uhi22/ccs32dave/readme.md

# ccs32dave - The CCS Sniffer with ESP32-S3, QCA7005 modem and TFT display

ccs32dave live during a charging session: the log shows CurrentDemandReq/Res in both directions, and the right-hand panel shows TARGET 230.0V/10.0A, PRESENT 231.0V/10.0A, SoC 0%, and the last message CurrentDemandReq OK.

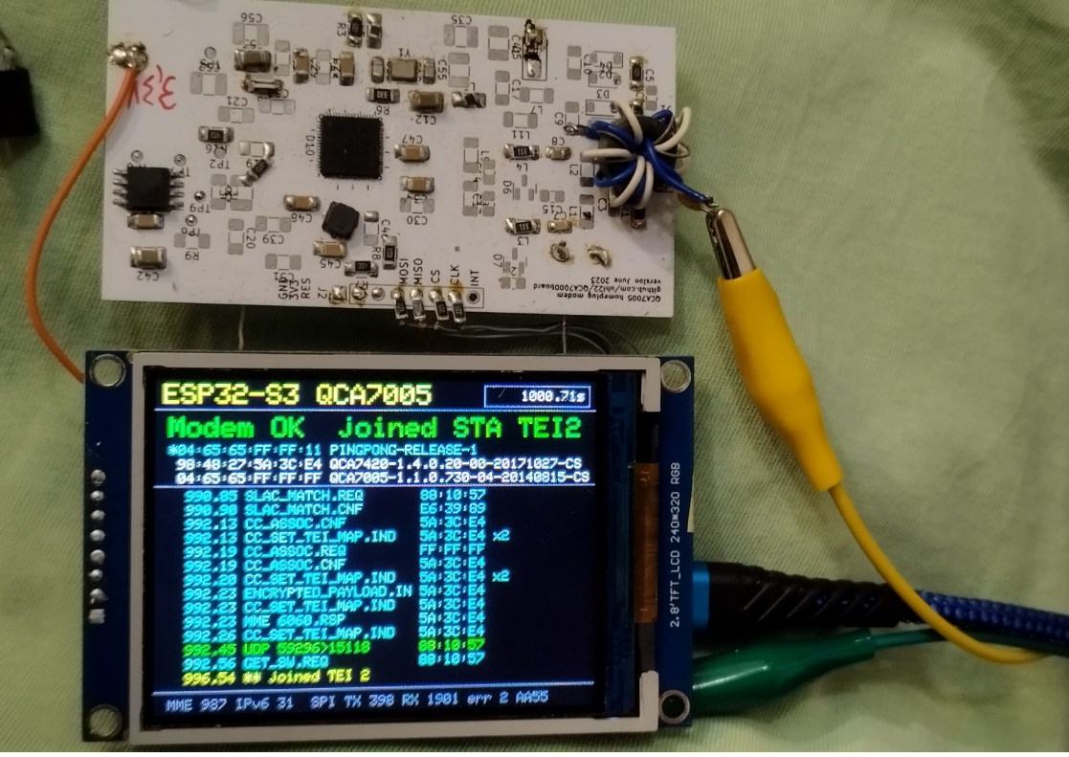
[picture p1: doc/2026-09-14_TFT_and_QCA_showing_SLAC_and_UDP.jpg]
QCA7005 modem board wired to the ILI9341 TFT (earlier state - see "News" below for what changed since).


## News

- **Unjoined in-modem decrypt (V7014):** the local modem no longer joins the powerline network to
  make the traffic visible. It stays a passive, non-member listener, recovers the session key and
  decrypts the charging traffic inside the modem, and delivers the plaintext to the host - a less
  intrusive sniffer than the earlier join-and-forward firmware. This ESP32 firmware now pairs with
  the V7014 modem image (`qca-modem-firmware/make_v7014_release.py`); the older `PINGPONG-RELEASE-5`
  pair is in the git history. Flash the ESP32 and the modem from the same commit.
- Milestone reached: also for the AR7420 we have now a transparent sniffer software, see [pyPLC](https://github.com/uhi22/pyPLC#2026-10-09-ar7420-full-transparency-sniffer)
- **ccs32dave works in a real-world charging session:** sniffing tested successfully on a Hyundai Ioniq
  charging at an Alpitronic HYC300. See the [video on YouTube](https://www.youtube.com/watch?v=CvkjcjtfIfo).
- **Live DIN 70121 decode**, both directions: target/present voltage and
  current, SoC and the last message name and response code, updating in real time on the TFT.
- **New two-column screen:** a prominent V2G value panel next to the frame log, plus a splash screen at boot (project name, GitHub link, build date, local modem version).
- **Beacon meter:** shows whether a charger's modem (CCo) is in sight and how well its beacons are received, from the modem's 250 ms status frame.
- **Stale values fade out:** V2G values that are no longer updated turn gray.
- **Page 2 (push button):** SDP transport security (TLS or not) and the XML schemas offered by the car and selected by the charger. A red `TLS` in the header warns that the session is encrypted.
- **Page 3 (push button):** the charge parameter discovery - the car's limits next to the charger's, so it is visible which side caps the session.
- **Pages 4-9:** session timeline, SLAC attenuation profile, a live voltage/current chart, identity and keys (including the session's NID and NMK), the energy delivered, and a message ladder diagram.

## Description

Arduino project that drives an **ILI9341 SPI TFT** (240×320) and a **QCA7005 HomePlug Green PHY modem** (compatible with QCA7000) from an **ESP32-S3**. Passively decodes the ISO 15118 / DIN 70121 charging session between a car and a charger and shows the live values on the TFT.

At boot, a **splash screen** shows for ~5 s: project name, GitHub link, build date/time, and (if it answers in time) the local modem's own software version - then switches to the main screen below.

The main screen shows:

- The local modem's status (SPI signature)
- A **beacon meter** (`beacons` + 5 segments): how well a charger's modem (CCo) is being received, from the delimiter counts in the modem's 250 ms status frame. Grey and empty when no status frame or no beacons arrive. The V7014 modem never joins a network, so there is no join/role/TEI to show.
- Up to 3 modems in the network with MAC and software version (HomePlug `GET_SW`). The local modem, whose MAC ends in `FF:FF:11`, is marked with `*`.
- Below the modem panel, two columns: a **frame log** on the left (events, MME/message names, UDP) and a prominent **V2G value panel** on the right - big stacked numbers for target/present voltage and current, SoC, the last decoded message name and its response code
- Traffic, delimiter (SOF/SACK, from the status frame) and SPI counters
- In the header: the uptime in seconds with **10 ms resolution**, refreshed every **50 ms** (20 Hz), and a red `TLS` once the charger's SDP response selected TLS (orange `TLS?` if only the car's request asked for it)

A push button (see "Page button" below) cycles through the nine pages and back to the main page. Over the serial line, `page <n>` jumps straight to one.

Page 2 is one page in two stacked parts, each with its own heading in the same format (yellow, size 2, same left edge) and a single separator line between them - no line under the top heading:

- **SDP:** what the car requests (TLS / no TLS, TCP / UDP), what the charger answers (the same, plus its IPv6 address and TCP port). Green = no TLS, red = TLS.
- **schema** (the lower section's heading): up to 5 schemas offered by the car (SchemaID, priority, version, namespace such as `urn:din:70121:2012:MsgDef`), the charger's response code, and the selected one marked with `>` - the negotiated protocol is repeated at the bottom in size-3 digits (e.g. `-> DIN 70121`), since that is the page's conclusion.
- The page stays coloured while the session is alive (any SDP or V2G message) and grays as a whole after 3 s without traffic. A SLAC match clears it, so values of the previous session can't reappear as current.
- Page 2 has no `ccs32dave` and no uptime either. **Only the main page has the uptime box**; every other page uses the header band for a heading, and the `TLS` warning moves to the right edge in small text.

Page 3 shows the **charge parameter discovery** in two columns - the car's request on the left (yellow, like the main page's TARGET block), the charger's response on the right (green, like PRESENT):

- **Car** (`ChargeParameterDiscoveryReq`): requested energy transfer mode (e.g. `DC extended`), maximum voltage and current in size-3 digits, the SoC sent with the request, the `EVReady` flag, the optional `full` / `bulk` SoC targets and the DC error code (green `NO_ERROR`, otherwise red; the names are shortened to fit, the full DIN names are in the comment above `evErrorName()`).
- **Charger** (`ChargeParameterDiscoveryRes`): `Ongoing` (orange) or `Finished` (green), maximum voltage, current and power in size-3 digits, the minimum voltage and current, and the response code.
- Fields the message doesn't carry show `-`: the SoC targets and the maximum power are optional in DIN, and while the charger answers `Ongoing` it may leave out its whole parameter block.
- Same session colouring as page 2 (gray after 3 s of quiet, cleared on a SLAC match).
- The header belongs to the page: `ccs32dave` and the uptime box are replaced by the page name, and the `TLS` warning moves to the right edge in small text (with TLS there is no discovery data to show at all). Both come back on pages 1 and 2.

Pages 4 to 9 each take one topic. Like page 3, they put their own name in the header in place of
`ccs32dave` and the uptime, and they gray out together with pages 2 and 3 once the session has
been quiet for 3 s:

- **Page 4 - session timeline** (backlog_0014): one bar per phase (SLAC, join, SDP, handshake,
  setup..CPD, CableCheck, PreCharge, CurrentDemand, stop) with its duration. Green = finished,
  yellow = running, red = this is where the session stopped, grey = never reached. Bar length is
  the phase's share of the longest one.
- **Page 5 - SLAC quality** (backlog_0015): the attenuation profile from `CM_ATTEN_CHAR.IND`, one
  bar per carrier group in dB (green below 30, yellow below 45, red above), plus the number of
  sounds received, the SLAC duration and the average and worst attenuation. **On this bench the
  profile is synthetic**: pyPLC has no measurements from the AR7420 and sends a constant 9 dB with
  three rising values at the top end, so the curve does not move. Against a real charger it is a
  fingerprint of the coupling.
- **Page 6 - voltage and current** (backlog_0016): a sweeping plot of the present voltage (green,
  left scale) and current (yellow, right scale) over the last 120 s, one sample per 400 ms. The
  newest sample overwrites the oldest column, so the two-pixel gap shows where "now" is. Both
  scales round up to a readable step on their own, and the current values stand above the plot.
- **Page 7 - identity and keys** (backlog_0017): the car (EVCCID, or the PEV MAC from the SLAC
  match), the charger's MAC, the V2G SessionID, and the NID and NMK the session runs on. The
  payment option was dropped as uninteresting (owner decision 2026-09-22).
- **Page 8 - energy** (backlog_0020): energy in kWh and charge in Ah integrated over the present
  values, average and peak power, how long current actually flowed, and the phase reached.
- **Page 9 - message ladder** (backlog_0021): car on the left rail, charger on the right, one
  arrow per exchange with an arrowhead per direction. Repeats of the same exchange collapse into
  one row with a count (`CurrentDemand x176` with a two-way arrow), so a charge loop doesn't push
  the session start off the page.

```
+-------------------------------------------------------+
| ccs32dave       (yellow, size 2)       [    1234.56s] |
|---------------------------------------------------------
| Modem OK (green/red)     beacons [#####]  (size 2)     |
| *04:65:65:FF:FF:11 <local version>            (cyan)   |
|  98:48:27:5A:3C:E4 QCA7420-1.4.0.20-00-20171027-CS     |
|  04:65:65:FF:FF:FF QCA7005-1.1.0.730-04-20140815-CS    |
|------------------------------------|------------------|
| 12.3 ** modem OK             (yel) | TARGET     (grey)|
| 13.1 SLAC_PARAM.REQ    10:57 (cy)  | 230.0V   (yellow)|
| ...                                 | 10.0A    (yellow)|
| 16.0 SessionSetupReq   10:57 (grn) | PRESENT    (grey)|
| 16.1 CurrentDemandReq  10:57 (grn) | 230.0V    (green)|
| 16.1 CurrentDemandRes  39:89 (grn) | 10.0A     (green)|
|  ... (14 lines, newest at bottom)  | SoC        (grey)|
|                                     | 0%          (cy)|
|                                     | CurrentDemandRes |
|                                     | OK         (grn) |
|---------------------------------------------------------
| MME 42 IPv6 800  SPI TX 24 RX 1900 err 0 AA55  (grey)  |
+-------------------------------------------------------+
```

Page 3 (charge parameter discovery) - the page name replaces `ccs32dave` and the uptime box in
the header here, so the values can use the whole screen:

```
+-------------------------------------------------------+
| ChargeParameterDiscovery       (yellow, size 2)  [TLS] |
|---------------------------------------------------------
| CAR wants          (grey) | CHARGER          (grey)    |
| DC extended      (size 2) | Finished     (size 2, grn) |
| maximum             (grey)| maximum             (grey) |
| 410.0V   (yellow, size 3) | 450.0V     (green, size 3) |
| 125.0A   (yellow, size 3) | 200.0A     (green, size 3) |
| SoC 0%     (cyan, size 2) | 10.0kW     (green, size 3) |
| ready no (orange, size 2) | minimum             (grey) |
| full 100%  bulk 80%       | 200V 1A          (size 2)  |
| EV error code       (grey)| response            (grey) |
| NO_ERROR  (green, size 2) | OK         (green, size 2) |
|---------------------------------------------------------
| button: main page                               (grey) |
+-------------------------------------------------------+
```

Planned next steps are in [backlog.md](backlog.md).

## Project layout

```
readme.md                                    this file
backlog.md                                   planned work
doc/                                         photos
ccs32dave-arduino-esp32-s3-tft-ili9341.ino   Arduino sketch: display, splash screen, scheduling
qca7000.h/.cpp                               QCA7000/QCA7005 SPI driver
homeplug.h/.cpp                              HomePlug messages (GET_SW, NW_INFO, MME names,
                                              vendor MMEs VS_RD_MEM/VS_WR_MEM/VS_NW_INFO)
modem_list.h/.cpp                            table of the modems in the network
diag.h/.cpp                                  serial diagnosis interface (rd/wr/nwi/pp/stat/...)
v2gtp.h/.cpp                                 TCP reassembly + V2GTP framing (no TCP stack)
v2g_exi.h/.cpp                               DIN 70121 / app-handshake EXI decode glue
src/exi/                                     OpenV2G EXI codec (decoder-only), ported from
                                              ccs32berta - see backlog.md backlog_0001 step 2
qca-modem-firmware/                          script that builds the modem's sniffer firmware
                                              (see "QCA7005 sniffer firmware")
```

The sketch folder is the repository root. Arduino requires the `.ino` file to have the same name as its folder.

The modem code is ported from [ccs32berta](https://github.com/uhi22/ccs32berta) and cleaned up into small C++ modules; so is the EXI codec in `src/exi/` (decoder-only - only the DIN and app-handshake decoders are used, not the encoders).

## Hardware

- ESP32-S3 board with an ESP32-S3-WROOM-1 module and two USB-C ports labeled "USB" and "COM" (DevKitC-1 style). Tested with this board.
- ILI9341 SPI TFT module **without CS and MISO**, with the 7 pins `GND VCC CLK MOSI RES DC BLK`. This is the same module as in the STM32 project `TFT-with-CAN`.
- QCA7005 (or QCA7000) HomePlug modem with SPI access (3.3 V logic)
- Jumper wires

## Wiring

The TFT and the modem use **two separate SPI buses**. The TFT has no CS, so it would react to the modem's SPI traffic.

### TFT display (FSPI bus)

| TFT pin | ESP32-S3 pin | Sketch define | Notes |
|---|---|---|---|
| GND | GND | | |
| VCC | 3V3 | | Supply for the display controller |
| CLK | GPIO 12 | `TFT_SCLK` | FSPI SCK |
| MOSI | GPIO 11 | `TFT_MOSI` | FSPI MOSI |
| RES | GPIO 8 | `TFT_RST` | Hardware reset |
| DC | GPIO 9 | `TFT_DC` | Data/command select |
| BLK | 5V | `TFT_BL = -1` | Backlight, always on. Or use a GPIO (see notes) |
| *(CS)*  | – | `TFT_CS = -1` | Not on the module |
| *(MISO)*| – | `TFT_MISO = -1` | Not on the module |

The chosen GPIOs are free on every ESP32-S3 module variant. The wiring avoids GPIO 26–32 (SPI flash), GPIO 33–37 (octal PSRAM on N8R8 / N16R8 modules), GPIO 19/20 (USB D-/D+), GPIO 0/3/45/46 (strapping pins) and GPIO 43/44 (UART0, used by the "COM" port).

#### TFT notes

- **No CS:** the controller's chip select is tied active on the module, so the display must be the **only device on this SPI bus**. In the sketch, `TFT_CS` and `TFT_MISO` are set to `-1`, and the Adafruit driver then skips CS handling. The display is write-only, so MISO isn't needed.
- **SPI mode:** mode 0 (clock idle low, sample on the first edge), the same as in the STM32 project. The Adafruit driver uses mode 0 by default.
- **Backlight:** to switch the backlight from software, connect `BLK` to a free GPIO (e.g. GPIO 7) and set `#define TFT_BL 7` in the sketch. The backlight draws several tens of mA. If the module has no backlight transistor, use a small NPN/MOSFET switch instead of driving it directly from the GPIO.
- Keep the wires short (< 15 cm). The SPI clock runs at 40 MHz; the STM32 project used 18 MHz. If the picture shows glitches, lower `SPI_FREQUENCY` to `20000000`.
- To use different pins, change the `#define TFT_*` lines at the top of the sketch. The ESP32-S3 can route SPI to any free GPIO.

### QCA7005 modem (HSPI bus)

| QCA7005 pin | ESP32-S3 pin | Sketch define | Notes |
|---|---|---|---|
| GND | GND | | |
| SPI_CLK | GPIO 4 | `QCA_SCLK` | |
| SPI_SI | GPIO 5 | `QCA_MOSI` | ESP32 → modem |
| SPI_SO | GPIO 6 | `QCA_MISO` | Modem → ESP32 |
| SPI_CS | GPIO 15 | `QCA_CS` | Active low |
| INT | – | | Not connected; the sketch polls |

#### QCA7005 notes

- **SPI settings:** mode 3 (clock idle high) at 4 MHz. ccs32berta used 2 MHz; 4 MHz gives headroom for the sniffer stream and measured no SPI errors, while 8 MHz did (`QCA_SPI_FREQUENCY`).
- **Supply:** check the modem board's supply voltage before connecting. The SPI lines must be 3.3 V logic.
- **No interrupt:** the sketch polls the modem's receive buffer every 10 ms instead of using INT.
- **Diagnosis:** if the display shows `Modem: missing`, the signature read didn't return `AA55`. `FFFF` or `0000` usually means a wiring problem (MISO, CS, CLK) or no supply. While the signature is wrong, the serial port prints all internal registers every second (`QCA regs: ...`). If they all have the same value, the modem isn't decoding the commands.
- **Tested with:** local QCA7005 running the V7014 sniffer firmware (MAC `04:65:65:FF:FF:11`, unjoined in-modem decrypt - it never joins the network, decrypts the overheard traffic in the modem and delivers the plaintext to the host in both directions, on its own), on a testbench with a PEV modem (QCA7005, `MAC-QCA7005-1.1.0.730-04-20140815-CS`) and an EVSE modem (QCA7420, `MAC-QCA7420-1.4.0.20-00-20171027-CS`). Serial output after a reset:
  ```
  QCA7005 signature: AA55 (OK)
  ccs32dave started
  Modems: 1
    * 04:65:65:FF:FF:11 <local version>
  ```
  The local modem never joins, so it stays the only station it reports. Other modems answer
  `GET_SW` on the powerline, so the modem table may still list the PEV and EVSE modems while a
  session runs.

#### QCA7005 sniffer firmware

This ESP32 firmware pairs with the QCA7005 sniffer firmware **V7014**, built by
`qca-modem-firmware/make_v7014_release.py`. (The earlier join-and-forward `PINGPONG-RELEASE-5`
firmware and its builder are in the git history; flash the matching pair from one commit.)

V7014 is an **unjoined in-modem decrypt** sniffer: the modem never joins the powerline network. It
passively overhears the charging traffic, recovers the session key and decrypts the payload inside
the modem, and delivers the plaintext to the host as native IPv6 frames plus a 250 ms status frame
(which drives the beacon meter and the SOF/SACK counters). This repository doesn't contain the
firmware, because it is based on the modem vendor's firmware; the script builds the image from an
original flash image that you obtain yourself:

1. The input is an original 2 MB SPI flash image with the QCA7005 firmware
   `MAC-QCA7005-1.1.0.730-04-20140815-CS`. Apart from the per-device parameter blocks (PIB:
   MAC address, keys), it must be identical to the image this release was tested with. The
   script checks this and refuses anything else. Your image's own keys are kept. The file name
   doesn't matter; the default is `original_1.1.0.730-04-CS-20140815.bin`. (The same original
   image also works with the older `make_pingpong_release_5.py` in the git history.)
2. Build the image (only Python 3 is needed):
   ```
   python qca-modem-firmware/make_v7014_release.py original_1.1.0.730-04-CS-20140815.bin
   ```
   This writes `qca_flash_V7014.bin` with the MAC `04:65:65:FF:FF:11`. Use
   `--mac` for a different one. The MAC must differ from every other modem on the line. The input
   dump uses `04:65:65:FF:FF:FF`, like many other boards (e.g. Foccci).
3. Write the image to the QCA7005's SPI flash with any SPI flash programmer. One way is a
   Raspberry Pi with `flashrom`, with the QCA7005 held in reset while flashing. **Read a backup
   of the original flash first.**

The modem only boots a compressed firmware of exactly the right size, so the script checks that
its result is bit-identical to the build tested on hardware. If it isn't, the script stops and
writes nothing. It was tested on Windows 10 x64 with Python 3.11.7.

**Disclaimer, use at your own risk, no warranty:** flashing can leave the modem unusable until it
is flashed again with a working image. This firmware passively decrypts the charging traffic it
overhears, in the modem. Use it only on your own equipment or where you are allowed to, and be
aware that even a passive, non-joining station in range can in principle affect a charging session.

### Page button

| Button | ESP32-S3 pin | Sketch define | Notes |
|---|---|---|---|
| one side | GPIO 16 | `PAGE_BUTTON_PIN` | Internal pull-up; a press steps to the next of the nine pages and wraps to the main page (30 ms debounce). `page <n>` on the serial line jumps directly |
| other side | GND | | |

GPIO 16 is free on every ESP32-S3 module variant (it is only a 32 kHz crystal pin if such a crystal is fitted, which the DevKitC-1 doesn't have). The BOOT button isn't used because it's hard to reach.

## Software

### Requirements

- Arduino IDE 2.x **or** just `arduino-cli`. The IDE isn't needed; see [Command line only](#command-line-only-no-arduino-ide)
- **esp32** board package by Espressif, version 3.x (tested with 3.0.2)
- Libraries, from the Library Manager:
  - **Adafruit ILI9341** (tested with 1.6.3)
  - **Adafruit GFX Library** (tested with 1.12.6)
  - **Adafruit BusIO**, which is installed automatically as a dependency

The sketch uses the Adafruit libraries rather than TFT_eSPI. TFT_eSPI has known compatibility problems with esp32 core 3.x on the ESP32-S3.

### Board settings (Arduino IDE)

- Board: **ESP32S3 Dev Module**
- Everything else can stay at the defaults

### USB port

Connect the board's **"COM"** USB-C port. It has a USB-to-serial chip on UART0, which:

- puts the ESP32 into download mode automatically, so you don't need to press BOOT/RESET
- shows `Serial` output without the "USB CDC On Boot" setting
- stays available when the sketch crashes

The "USB" port is the ESP32-S3's native USB and isn't needed here. If Windows shows no COM port, install the driver for the USB-to-serial chip (CH343 or CP210x).

### Command line only (no Arduino IDE)

Everything (setup, build, upload, serial monitor) works with `arduino-cli` alone.

**1. Install arduino-cli**

```sh
winget install ArduinoSA.CLI
```

Or download it from <https://arduino.github.io/arduino-cli/latest/installation/>. If the Arduino IDE 2.x is already installed, it contains a copy of the CLI:
`%LOCALAPPDATA%\Programs\Arduino IDE\resources\app\lib\backend\resources\arduino-cli.exe`

**2. Install the ESP32 board package and the libraries** (one time)

```sh
arduino-cli config init
arduino-cli config add board_manager.additional_urls https://espressif.github.io/arduino-esp32/package_esp32_index.json
arduino-cli core update-index
arduino-cli core install esp32:esp32
arduino-cli lib install "Adafruit ILI9341" "Adafruit GFX Library"
```

`arduino-cli config init` fails if a config file already exists, e.g. because the Arduino IDE created one. That's fine: continue with the next command. To get the tested version, use `esp32:esp32@3.0.2`.

#### Already set up on the dev/bench PC (2026-09-15)

Everything above is already installed on the Windows machine this project is normally worked on
from (`C:\UwesTechnik\...`) - no need to (re-)install, just use these paths directly:

- `arduino-cli.exe`: `C:\Users\uwemi\AppData\Local\Programs\Arduino IDE\resources\app\lib\backend\resources\arduino-cli.exe`
  (bundled with Arduino IDE 2.x, no separate `arduino-cli` install)
- Board package: `esp32:esp32` 3.0.2, in the default `Arduino15` data dir (`arduino-cli core list` to confirm)
- Libraries: **not** in the default `Documents\Arduino\libraries` - this account's Documents is
  OneDrive-redirected, so they're under
  `C:\Users\uwemi\OneDrive\Dokumente\Arduino\libraries\` (`Adafruit_GFX_Library` 1.12.6,
  `Adafruit_BusIO` 1.17.4, `Adafruit_ILI9341` 1.6.3 - `arduino-cli lib list` to confirm/update)
- Compile-check (no upload, no board needed - use this to verify a change before touching hardware):
  ```sh
  "C:\Users\uwemi\AppData\Local\Programs\Arduino IDE\resources\app\lib\backend\resources\arduino-cli.exe" compile --fqbn esp32:esp32:esp32s3 "C:\UwesTechnik\ccs32dave-arduino-esp32-s3-tft-ili9341"
  ```
- The ESP32 is on **COM11** on this bench (fixed, not just the doc's placeholder value) - confirm with `arduino-cli board list` if it's been replugged.

**3. Build and upload**

Run these commands in the sketch folder `ccs32dave-arduino-esp32-s3-tft-ili9341`:

```sh
arduino-cli board list
arduino-cli compile --upload -p COM11 --fqbn esp32:esp32:esp32s3 .
```

Replace `COM11` with the port shown by `arduino-cli board list`. The FQBN `esp32:esp32:esp32s3` is the "ESP32S3 Dev Module" from the IDE, with the default settings.

**4. Serial monitor**

```sh
arduino-cli monitor -p COM11 -c baudrate=115200
```

After a reset it shows `ESP32-S3 TFT + QCA7005 demo started`. Exit with Ctrl+C. Close any serial monitor (CLI or IDE) before uploading, because it blocks the port.

## How it works

### Startup

`setup()` starts the TFT on the FSPI bus (40 MHz, landscape 320×240), then calls `showSplashScreen()`
(project name, GitHub link, build date/time, ~5 s, also starts the modem on the HSPI bus and tries
to catch its own `GET_SW.CNF` within that window - see "Splash screen" below), draws the static
labels, and does the first modem check.

### Main loop

`loop()` is a small non-blocking scheduler:

| Interval | Task |
|---|---|
| 1 s | `checkModem()`: reads the signature register (`0xAA55` = modem present). If the modem disappears, the modem table is cleared and the beacon meter goes stale. When it comes back, the requests are sent immediately. |
| 5 s | `sendRequests()`: broadcast `GET_SW.REQ` for the modem list; modems that didn't answer for 3 cycles (15.5 s) are removed |
| 1 s | `sendStatusRequests()`: only re-sends `VS_SNIFFER.REQ` while the sniffer stream is forced on via `sniff on` (`diag`). The V7014 modem emits its 250 ms status frame on its own, so nothing is polled for it. |
| 10 ms | `qca.poll()`: if the modem reports received data (`RDBUF_BYTE_AVA`), reads it, splits it into Ethernet frames and passes each one to `onEthFrame()` (see below) |
| per poll | `diag.loop()`: serial diagnosis commands (`rd`/`wr`/`nwi`/`pp`/`stat`/`qreset`/`bcast`/`log`) |
| every pass | `pollPageButton()`: on a debounced press, `showPage()` clears everything below the header and redraws the other page |
| 50 ms | Uptime display |
| on change, and every 500 ms | `drawHeaderHint()` (`TLS`), then `drawPanel()` (main page) or `drawPage2()`: redraws only the text lines whose content or color changed (the 500 ms tick lets stale values fade) |
| on change, max. every 200 ms | `drawLog()`: redraws the frame log (main page only; entries are still collected on pages 2 and 3) |

`onEthFrame()` first offers the frame to `diag` (answers to a pending serial command are consumed
there, not shown as traffic), then sorts the rest:

- **Status frame (`0x88E1`, MMTYPE `0x0000`, payload `STAT`):** the V7014 modem's own 250 ms telemetry
  frame. Parsed for the cumulative beacon/SOF/SACK delimiter counts; the beacon meter is the per-frame
  delta of the beacon count, SOF/SACK are shown on the counter line. Not logged.
- **`GET_SW.CNF`:** added to the modem table. Other modems answer `GET_SW` on the powerline, so the
  PEV and EVSE modems may appear even though the local modem never joins.
- **`VS_SNIFFER` (`0xA034`-`0xA036`):** not logged and not counted as traffic. The stream is off by
  default (the status frame replaces it); it is enabled only by `sniff on` (`diag`) as a raw test aid.
- **Other HomePlug MMEs:** counted and added to the frame log (e.g. `SLAC_MATCH.CNF`).
- **IPv6 UDP:** counted. SDP request/response (V2GTP payload type `0x9000`/`0x9001`) is decoded for
  page 2 and logged as e.g. `SDP req no TLS TCP`; other UDP frames are logged with protocol and ports.
- **IPv6 TCP:** payload handed to the V2GTP reassembler (`v2gtp`); a completed message goes to the
  EXI decoder (`v2g_exi`) and the result (message name, and any of target/present V+A, SoC, response
  code it carries, or the offered/selected schemas of the app handshake) updates the TFT. Individual TCP segments (mostly bare ACKs) are not logged on the
  TFT - only UDP frames and decoded/failed V2G messages are, to keep the 12-line ring buffer useful.

Every counted frame's raw description is printed on the serial port unconditionally via
`logFrame()` (command `log 0` turns this off); it includes TCP flags/sequence/payload-length/V2GTP-
length for TCP. Changes of the modem table and the shown V2G values are always printed, independent
of that setting (same convention: print on change, not on every event).

### Modules

- **`qca7000`:** SPI protocol of the modem (chargebyte AN4). Internal register reads/writes
  (`readRegister()` is public - used by the splash screen and `diag`'s `stat` command), a soft
  reset via `SPI_CONFIG`'s `SLAVE_RESET` bit (`qreset` - only clears the SPI buffers, not the CPU;
  a wedged QCA needs a real reset line pulse), and the framing `AA AA AA AA | length | 00 00 |
  frame | 55 55` for sending and receiving Ethernet frames. It counts TX/RX/rejected frames and
  errors.
- **`homeplug`:** builds `GET_SW.REQ` (Qualcomm vendor MME `0xA000`, OUI `00:B0:52`), the vendor MMEs `VS_RD_MEM`/`VS_WR_MEM`/`VS_NW_INFO` (`0xA008`/`0xA004`/`0xA038`) used by `diag` to talk to the patched local modem over SPI, and `VS_SNIFFER.REQ` (`0xA034`, stock firmware) for the `sniff on` test aid. It parses the matching `.CNF`s, parses the V7014 status frame (`parseStatusFrame`), and turns MMTYPEs into readable names.
- **`modem_list`:** table of up to 3 modems, keyed by MAC, with the local modem always first. Entries expire when a modem stops answering.
- **`diag`:** serial command interface, including `sniff on|auto` and `page <n>` (see its own header for the full list) - the diagnosis
  channel for a modem that has no other host link (no JTAG, no Ethernet to the QCA on this board).
- **`v2gtp`:** TCP reassembly + V2GTP message framing, keyed by source MAC, without a TCP stack.
- **`v2g_exi`:** decodes one complete EXI payload (DIN 70121, or the app-handshake) using the ported
  OpenV2G codec in `src/exi/`.

### Splash screen

`showSplashScreen()` runs once at boot, for 5 s (`SPLASH_DURATION_MS`): a bordered screen with a
typewriter-revealed title ("ccs32dave"), subtitle, the GitHub link, the build date/time
(`__DATE__ __TIME__`), a progress bar filling over the 5 s, and two pulsing lightning-bolt icons.
It also starts the QCA link (`qca.begin()`) and, as soon as the signature reads OK, sends one
`GET_SW.REQ` and polls for the local modem's own answer for the rest of the window - if it arrives,
"Local modem: detecting..." is replaced with the real version string and the modem table is seeded
with it, so the main screen shows it immediately without an extra wait. Purely cosmetic and
blocking - nothing else needs to run during it.

### Display

- **Status and modem lines:** each line is padded to its full width and drawn with a background color, so old text is erased without clearing the screen.
- **Two-column layout below the modem panel** (owner request 2026-09-15, replacing an earlier
  two-line design): a vertical divider splits the remaining screen into the frame log (left) and a
  V2G value panel (right). The log gave up width for this - see below - so the panel could give the
  numbers real prominence instead of squeezing them into shared text lines.
- **V2G value panel:** "big stacked numbers" - a size-1 label above each size-2 value: `TARGET`
  voltage+current (yellow, from the car's `CurrentDemandReq`), `PRESENT` voltage+current (green,
  from the charger's `CurrentDemandRes`/`PreChargeRes`), `SoC` (cyan), the last decoded message name
  (green = decoded OK, red = a decode error), and its response code (blank until known, `OK` in
  green, `RC <n>` in red for any fault code - see `dinresponseCodeType` in
  `src/exi/dinEXIDatatypes.h` for the full list). Values persist across messages (e.g.
  `CurrentDemandRes` doesn't repeat the target values) until a newer message updates them. A value
  not updated for 2 s turns mid-gray, after 4 s dark gray. Each row is its own `TextLine`, so only
  the ones that actually changed get redrawn.
- **Beacon meter:** the network line always shows `beacons` (orange) and 5 segments, driven by the
  V7014 modem's 250 ms status frame: the level is the number of beacons the modem received in the
  last status interval (a CCo beacons every ~40 ms, so ~6 arrive per 250 ms and the meter sits full),
  capped at 5. It turns grey and empties when no status frame arrives within ~1.2 s (e.g. the modem
  is absent, or still runs the old join-and-forward firmware, which sends no status frame).

  The V7014 modem never joins the network, so there is no "joined/not joined" state. The
  `VS_SNIFFER.IND` delimiter stream is **not** used for the meter and is left off; `sniff on` (serial)
  turns it on only as a raw test aid.
- **Frame log:** a ring buffer of 14 entries, narrowed (not shortened) to make room for the panel:
  uptime in whole seconds, MME/message name (still the full 20 characters it always had), and the
  last **2** bytes of the source MAC (was 3 - the extra byte wasn't worth the width once the panel
  needed it more). Consecutive identical entries are combined (`x10`, may get silently clipped by
  the narrower canvas on a very repetitive line - cosmetic only). Events (modem OK/missing) are
  shown in yellow; decoded V2G messages in green, decode errors in red. The
  log is rendered into a `GFXcanvas16` sized to the narrowed column and sent as one bitmap, at most
  every 200 ms.
- **Uptime:** read from `esp_timer_get_time()`, which is 64-bit microseconds, so it doesn't overflow after 49 days like `millis()`. The fixed-width string `%8llu.%02us` is rendered into a 72×8 canvas and sent in one `drawRGBBitmap()` call. This avoids flicker.

## References

- [Ref1] Discussion of this project on the openinverter forum: https://openinverter.org/forum/viewtopic.php?t=7346
- [Ref2] YouTube  video of a real-world charging session (Hyundai Ioniq at Alpitronic HYC300): https://www.youtube.com/watch?v=CvkjcjtfIfo
- [Ref3] Prior work, pyPLC, the open source CCS communication solution: https://github.com/uhi22/pyPLC
- [Ref4] The openinverter forum thread where all the CCS open source work started: https://openinverter.org/forum/viewtopic.php?t=2262
