uhi22/ccs32dave/homeplug.cpp

#include "homeplug.h"

namespace homeplug {

static constexpr uint16_t MMTYPE_GET_SW = 0xA000;
static constexpr uint16_t MMTYPE_NW_INFO = 0x6038;

static constexpr uint16_t MMTYPE_REQ = 0x0000;
static constexpr uint16_t MMTYPE_CNF = 0x0001;
static constexpr uint16_t MMTYPE_IND = 0x0002;

static const uint8_t MAC_BROADCAST[6] = {0xFF, 0xFF, 0xFF, 0xFF, 0xFF, 0xFF};
static const uint8_t QUALCOMM_OUI[3] = {0x00, 0xB0, 0x52};

// Offsets in a HomePlug AV management frame
static constexpr uint8_t OFS_MMV = 14;
static constexpr uint8_t OFS_MMTYPE = 15;         // little endian
static constexpr uint8_t OFS_OUI = 17;            // vendor MMEs (MMV 0)
static constexpr uint8_t OFS_SW_VERSION_LEN = 22; // GET_SW.CNF
static constexpr uint8_t OFS_SW_VERSION = 23;     // GET_SW.CNF

// MMV 1 (HomePlug AV 1.1) has a 2 byte fragmentation header (FMI) after the MMTYPE
static constexpr uint8_t MMV_AV10 = 0x00;
static constexpr uint8_t MMV_AV11 = 0x01;

// CM_NW_INFO.CNF: NumNWs, then per network 18 bytes
static constexpr uint8_t NW_INFO_ENTRY_LEN = 18;

struct MmtypeName {
  uint16_t base;
  const char *name;
};

static const MmtypeName MMTYPE_NAMES[] = {
    {0x0030, "CC_ASSOC"},       {0x0038, "CC_SET_TEI_MAP"},
    {0x6000, "UNASSOCIATED_STA"}, {0x6004, "ENCRYPTED_PAYLOAD"},
    {0x6008, "SET_KEY"},        {0x600C, "GET_KEY"},
    {0x6038, "NW_INFO"},        {0x6044, "MME_ERROR"},
    {0x6048, "NW_STATS"},       {0x6064, "SLAC_PARAM"},
    {0x6068, "START_ATTEN_CHAR"}, {0x606C, "ATTEN_CHAR"},
    {0x6074, "MNBC_SOUND"},     {0x6078, "VALIDATE"},
    {0x607C, "SLAC_MATCH"},     {0x6084, "ATTEN_PROFILE"},
    {0xA000, "GET_SW"},
};

uint16_t etherType(const uint8_t *frame) {
  return (frame[12] << 8) | frame[13];
}

uint16_t mmtype(const uint8_t *frame) {
  return frame[OFS_MMTYPE] | (frame[OFS_MMTYPE + 1] << 8);
}

void describeMmtype(uint16_t mm, char *buf, size_t bufLen) {
  static const char *const SUFFIX[4] = {"REQ", "CNF", "IND", "RSP"};
  uint16_t base = mm & ~0x0003;
  for (const MmtypeName &entry : MMTYPE_NAMES) {
    if (entry.base == base) {
      snprintf(buf, bufLen, "%s.%s", entry.name, SUFFIX[mm & 0x0003]);
      return;
    }
  }
  snprintf(buf, bufLen, "MME %04X.%s", base, SUFFIX[mm & 0x0003]);
}

// Header up to and including the MMTYPE; returns the offset of the payload
static uint8_t composeHeader(uint8_t *frame, const uint8_t sourceMac[6],
                             uint8_t mmv, uint16_t mm) {
  memset(frame, 0, MIN_ETH_FRAME_LEN);
  memcpy(&frame[0], MAC_BROADCAST, 6);
  memcpy(&frame[6], sourceMac, 6);
  frame[12] = ETHERTYPE_HOMEPLUG >> 8;
  frame[13] = ETHERTYPE_HOMEPLUG & 0xFF;
  frame[OFS_MMV] = mmv;
  frame[OFS_MMTYPE] = mm & 0xFF;
  frame[OFS_MMTYPE + 1] = mm >> 8;
  return (mmv == MMV_AV10) ? 17 : 19;  // FMI bytes stay 0
}

// Offset of the payload in a received MME, depending on its MMV
static uint8_t payloadOffset(const uint8_t *frame) {
  return (frame[OFS_MMV] == MMV_AV10) ? 17 : 19;
}

uint16_t composeGetSwReq(uint8_t *frame, const uint8_t sourceMac[6]) {
  uint8_t ofs = composeHeader(frame, sourceMac, MMV_AV10, MMTYPE_GET_SW | MMTYPE_REQ);
  memcpy(&frame[ofs], QUALCOMM_OUI, 3);
  return MIN_ETH_FRAME_LEN;
}

bool parseGetSwCnf(const uint8_t *frame, uint16_t len, SoftwareVersion &out) {
  if (len < OFS_SW_VERSION || etherType(frame) != ETHERTYPE_HOMEPLUG ||
      mmtype(frame) != (MMTYPE_GET_SW | MMTYPE_CNF)) {
    return false;
  }
  uint8_t versionLen = frame[OFS_SW_VERSION_LEN];
  if (versionLen == 0 || versionLen > VERSION_MAX_LEN ||
      OFS_SW_VERSION + versionLen > len) {
    return false;
  }

  memcpy(out.mac, &frame[6], 6);
  for (uint8_t i = 0; i < versionLen; i++) {
    char c = frame[OFS_SW_VERSION + i];
    out.version[i] = (c < 0x20 || c > 0x7E) ? ' ' : c;  // unprintable -> space
  }
  // The string is zero-padded; drop the padding
  while (versionLen > 0 && out.version[versionLen - 1] == ' ') {
    versionLen--;
  }
  out.version[versionLen] = '\0';
  return true;
}

uint16_t composeNwInfoReq(uint8_t *frame, const uint8_t sourceMac[6]) {
  composeHeader(frame, sourceMac, MMV_AV11, MMTYPE_NW_INFO | MMTYPE_REQ);
  return MIN_ETH_FRAME_LEN;
}

bool parseNwInfoCnf(const uint8_t *frame, uint16_t len, NetworkInfo &out) {
  if (len < 20 || etherType(frame) != ETHERTYPE_HOMEPLUG ||
      mmtype(frame) != (MMTYPE_NW_INFO | MMTYPE_CNF)) {
    return false;
  }
  uint8_t ofs = payloadOffset(frame);
  memset(&out, 0, sizeof(out));
  memcpy(out.mac, &frame[6], 6);
  out.numNetworks = frame[ofs];
  if (out.numNetworks > 0) {
    const uint8_t *nw = &frame[ofs + 1];
    if (ofs + 1 + NW_INFO_ENTRY_LEN > len) {
      return false;
    }
    memcpy(out.nid, &nw[0], 7);
    out.snid = nw[7];
    out.tei = nw[8];
    out.role = nw[9];
    memcpy(out.ccoMac, &nw[10], 6);
  }
  return true;
}

// ---- Qualcomm vendor MMEs for diagnosis ---------------------------------------

static constexpr uint16_t MMTYPE_VS_WR_MEM = 0xA004;
static constexpr uint16_t MMTYPE_VS_RD_MEM = 0xA008;
static constexpr uint16_t MMTYPE_VS_NW_INFO = 0xA038;
static constexpr uint8_t OFS_VS_PAYLOAD = 20;  // after the OUI

static void putLe32(uint8_t *p, uint32_t v) {
  p[0] = v & 0xFF;
  p[1] = (v >> 8) & 0xFF;
  p[2] = (v >> 16) & 0xFF;
  p[3] = v >> 24;
}

static uint32_t getLe32(const uint8_t *p) {
  return p[0] | (p[1] << 8) | (p[2] << 16) | ((uint32_t)p[3] << 24);
}

// Vendor MME header (MMV 0 + OUI) to dst; returns the payload offset
static uint8_t composeVendorHeader(uint8_t *frame, const uint8_t dst[6],
                                   const uint8_t src[6], uint16_t mm) {
  composeHeader(frame, src, MMV_AV10, mm);
  memcpy(&frame[0], dst, 6);
  memcpy(&frame[OFS_OUI], QUALCOMM_OUI, 3);
  return OFS_VS_PAYLOAD;
}

static bool isVendorCnf(const uint8_t *frame, uint16_t len, uint16_t mm, uint16_t minLen) {
  return len >= minLen && etherType(frame) == ETHERTYPE_HOMEPLUG &&
         mmtype(frame) == (mm | MMTYPE_CNF) &&
         memcmp(&frame[OFS_OUI], QUALCOMM_OUI, 3) == 0;
}

uint16_t composeRdMemReq(uint8_t *frame, const uint8_t dst[6], const uint8_t src[6],
                         uint32_t addr, uint32_t len) {
  uint8_t ofs = composeVendorHeader(frame, dst, src, MMTYPE_VS_RD_MEM | MMTYPE_REQ);
  putLe32(&frame[ofs], addr);
  putLe32(&frame[ofs + 4], len);
  return MIN_ETH_FRAME_LEN;
}

uint16_t composeWrMemReq(uint8_t *frame, const uint8_t dst[6], const uint8_t src[6],
                         uint32_t addr, const uint8_t *data, uint16_t n) {
  uint8_t ofs = composeVendorHeader(frame, dst, src, MMTYPE_VS_WR_MEM | MMTYPE_REQ);
  putLe32(&frame[ofs], addr);
  putLe32(&frame[ofs + 4], n);
  memcpy(&frame[ofs + 8], data, n);
  uint16_t len = ofs + 8 + n;
  return len < MIN_ETH_FRAME_LEN ? MIN_ETH_FRAME_LEN : len;
}

bool parseRdMemCnf(const uint8_t *frame, uint16_t len, MemReadResult &out) {
  // STATUS(1) addr(4) len(4) data
  if (!isVendorCnf(frame, len, MMTYPE_VS_RD_MEM, OFS_VS_PAYLOAD + 9)) {
    return false;
  }
  const uint8_t *p = &frame[OFS_VS_PAYLOAD];
  memcpy(out.mac, &frame[6], 6);
  out.status = p[0];
  out.addr = getLe32(&p[1]);
  out.len = getLe32(&p[5]);
  out.data = &p[9];
  if (out.status == 0 && OFS_VS_PAYLOAD + 9 + out.len > len) {
    return false;
  }
  if (out.status != 0) {
    out.len = 0;
  }
  return true;
}

bool parseWrMemCnf(const uint8_t *frame, uint16_t len, uint8_t mac[6], uint8_t &status) {
  if (!isVendorCnf(frame, len, MMTYPE_VS_WR_MEM, OFS_VS_PAYLOAD + 1)) {
    return false;
  }
  memcpy(mac, &frame[6], 6);
  status = frame[OFS_VS_PAYLOAD];
  return true;
}

uint16_t composeVsNwInfoReq(uint8_t *frame, const uint8_t dst[6], const uint8_t src[6]) {
  composeVendorHeader(frame, dst, src, MMTYPE_VS_NW_INFO | MMTYPE_REQ);
  return MIN_ETH_FRAME_LEN;
}

bool parseVsNwInfoCnf(const uint8_t *frame, uint16_t len, VsNetworkInfo &out) {
  // NUMAVLNs at 0x14 (wire offset; the programmer's guide says 0x18), then
  // NID(7) SNID TEI ROLE CCO_MAC(6) CCO_TEI NUMSTAS, then 15 bytes per station
  if (!isVendorCnf(frame, len, MMTYPE_VS_NW_INFO, 0x15)) {
    return false;
  }
  memset(&out, 0, sizeof(out));
  memcpy(out.mac, &frame[6], 6);
  out.numAvlns = frame[0x14];
  if (out.numAvlns == 0) {
    return true;
  }
  static constexpr uint16_t OFS_AVLN = 0x15;
  if (OFS_AVLN + 18 > len) {
    return false;
  }
  const uint8_t *a = &frame[OFS_AVLN];
  out.ownTei = a[8];
  out.role = a[9];
  memcpy(out.ccoMac, &a[10], 6);
  out.ccoTei = a[16];
  uint8_t stations = a[17];
  uint16_t pos = OFS_AVLN + 18;
  for (uint8_t i = 0; i < stations && out.numStations < VsNetworkInfo::MAX_STATIONS &&
                      pos + 15 <= len;
       i++, pos += 15) {
    memcpy(out.stations[out.numStations].mac, &frame[pos], 6);
    out.stations[out.numStations].tei = frame[pos + 6];
    out.numStations++;
  }
  return true;
}

// SLAC payload parsers (backlog_0015 / 0017). Both messages are broadcast or unicast on the
// CP line and reach us through the normal receive path - no request of ours is involved.
static constexpr uint16_t MMTYPE_ATTEN_CHAR = 0x606C;
static constexpr uint16_t MMTYPE_SLAC_MATCH = 0x607C;

bool parseAttenCharInd(const uint8_t *frame, uint16_t len, AttenProfile &out) {
  if (len < 24 || etherType(frame) != ETHERTYPE_HOMEPLUG ||
      mmtype(frame) != (MMTYPE_ATTEN_CHAR | MMTYPE_IND)) {
    return false;
  }
  uint8_t ofs = payloadOffset(frame);
  const uint16_t groupsOfs = ofs + 1 + 1 + 6 + 8 + 17 + 17 + 1 + 1;  // see the header comment
  if (groupsOfs > len) {
    return false;
  }
  out = AttenProfile();
  memcpy(out.pevMac, &frame[ofs + 2], 6);
  out.numSounds = frame[groupsOfs - 2];
  uint8_t groups = frame[groupsOfs - 1];
  if (groups > ATTEN_MAX_GROUPS) groups = ATTEN_MAX_GROUPS;
  if (groupsOfs + groups > len) {
    groups = (uint8_t)(len - groupsOfs);  // truncated frame: keep what is there
  }
  out.numGroups = groups;
  memcpy(out.attenuation, &frame[groupsOfs], groups);
  return groups > 0;
}

bool parseSlacMatchCnf(const uint8_t *frame, uint16_t len, SlacMatch &out) {
  if (etherType(frame) != ETHERTYPE_HOMEPLUG ||
      mmtype(frame) != (MMTYPE_SLAC_MATCH | MMTYPE_CNF)) {
    return false;
  }
  uint8_t ofs = payloadOffset(frame);
  const uint16_t pevMacOfs = ofs + 1 + 1 + 2 + 17;
  const uint16_t evseMacOfs = pevMacOfs + 6 + 17;
  const uint16_t nidOfs = evseMacOfs + 6 + 8 + 8;
  const uint16_t nmkOfs = nidOfs + 7 + 1;
  if (nmkOfs + 16 > len) {
    return false;
  }
  out = SlacMatch();
  memcpy(out.pevMac, &frame[pevMacOfs], 6);
  memcpy(out.evseMac, &frame[evseMacOfs], 6);
  memcpy(out.nid, &frame[nidOfs], 7);
  memcpy(out.nmk, &frame[nmkOfs], 16);
  return true;
}

// The QCA-DUT status frame: MMTYPE 0x0000, payload "STAT" + 32-bit LE words from wire byte 17.
bool parseStatusFrame(const uint8_t *frame, uint16_t len, StatusFrame &out) {
  static constexpr uint8_t OFS_STATUS = 17;   // payload start (fo+0x31 -> wire byte 17)
  static constexpr uint8_t STATUS_WORDS = 12; // w0..w11 (LAYOUT_VER 7) = 48 bytes
  if (len < OFS_STATUS + STATUS_WORDS * 4 || etherType(frame) != ETHERTYPE_HOMEPLUG ||
      mmtype(frame) != 0x0000 || memcmp(&frame[OFS_STATUS], "STAT", 4) != 0) {
    return false;
  }
  auto w = [&](uint8_t i) -> uint32_t {
    const uint8_t *p = &frame[OFS_STATUS + i * 4];
    return (uint32_t)p[0] | ((uint32_t)p[1] << 8) | ((uint32_t)p[2] << 16) | ((uint32_t)p[3] << 24);
  };
  out.layoutVer = (uint8_t)w(1);
  out.seq = w(2);  out.uptime = w(3);  out.seen = w(4);  out.cnfcnt = w(5);
  out.okcnt = w(6);  out.multicnt = w(7);  out.dropcnt = w(8);
  out.beacon = w(9);  out.sof = w(10);  out.sack = w(11);
  return true;
}

static constexpr uint16_t MMTYPE_VS_SNIFFER = 0xA034;

uint16_t composeVsSnifferReq(uint8_t *frame, const uint8_t sourceMac[6], bool enable) {
  uint8_t ofs = composeVendorHeader(frame, MAC_BROADCAST, sourceMac, MMTYPE_VS_SNIFFER | MMTYPE_REQ);
  frame[ofs] = enable ? 1 : 0;
  return MIN_ETH_FRAME_LEN;
}

bool isReceivedBeaconInd(const uint8_t *frame, uint16_t len) {
  static constexpr uint8_t OFS_DIRECTION = 0x15;
  static constexpr uint8_t OFS_FRAME_CONTROL = 0x22;
  static constexpr uint8_t DIRECTION_RX = 1;
  static constexpr uint8_t DELIMITER_BEACON = 0;
  return len >= OFS_FRAME_CONTROL + 16 && etherType(frame) == ETHERTYPE_HOMEPLUG &&
         mmtype(frame) == MMTYPE_VS_SNIFFER_IND &&
         memcmp(&frame[OFS_OUI], QUALCOMM_OUI, 3) == 0 &&
         frame[OFS_DIRECTION] == DIRECTION_RX &&
         (frame[OFS_FRAME_CONTROL] & 0x07) == DELIMITER_BEACON;
}

}  // namespace homeplug
